WRusman/FluidNC-BOB-v1.1/Schema.png

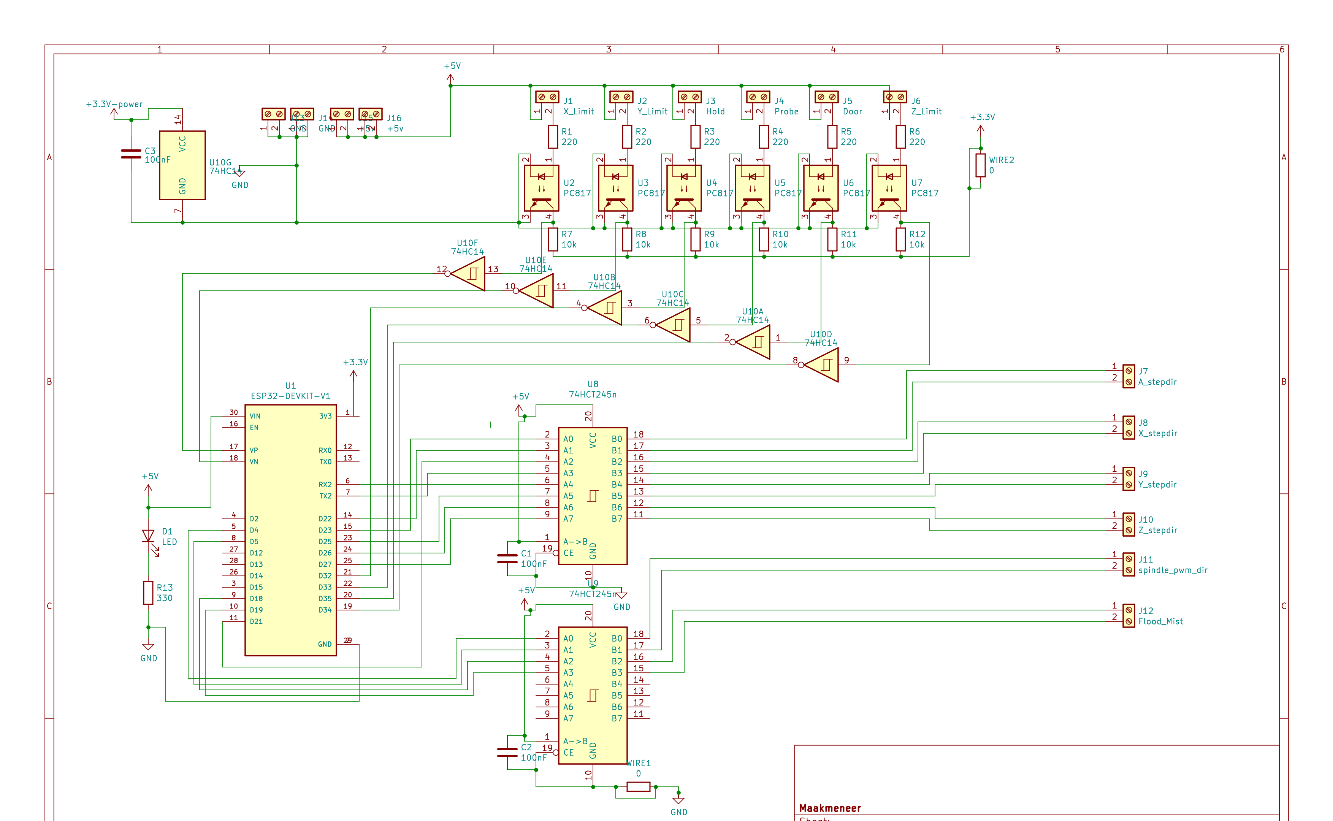
Schema.png
