WRusman/FluidNC-BOB-v1.1/FluidNC-BOB v1.1.kicad_pcb

## KiCad design FluidNC-BOB v1.1.kicad_pcb (2023-03-14)

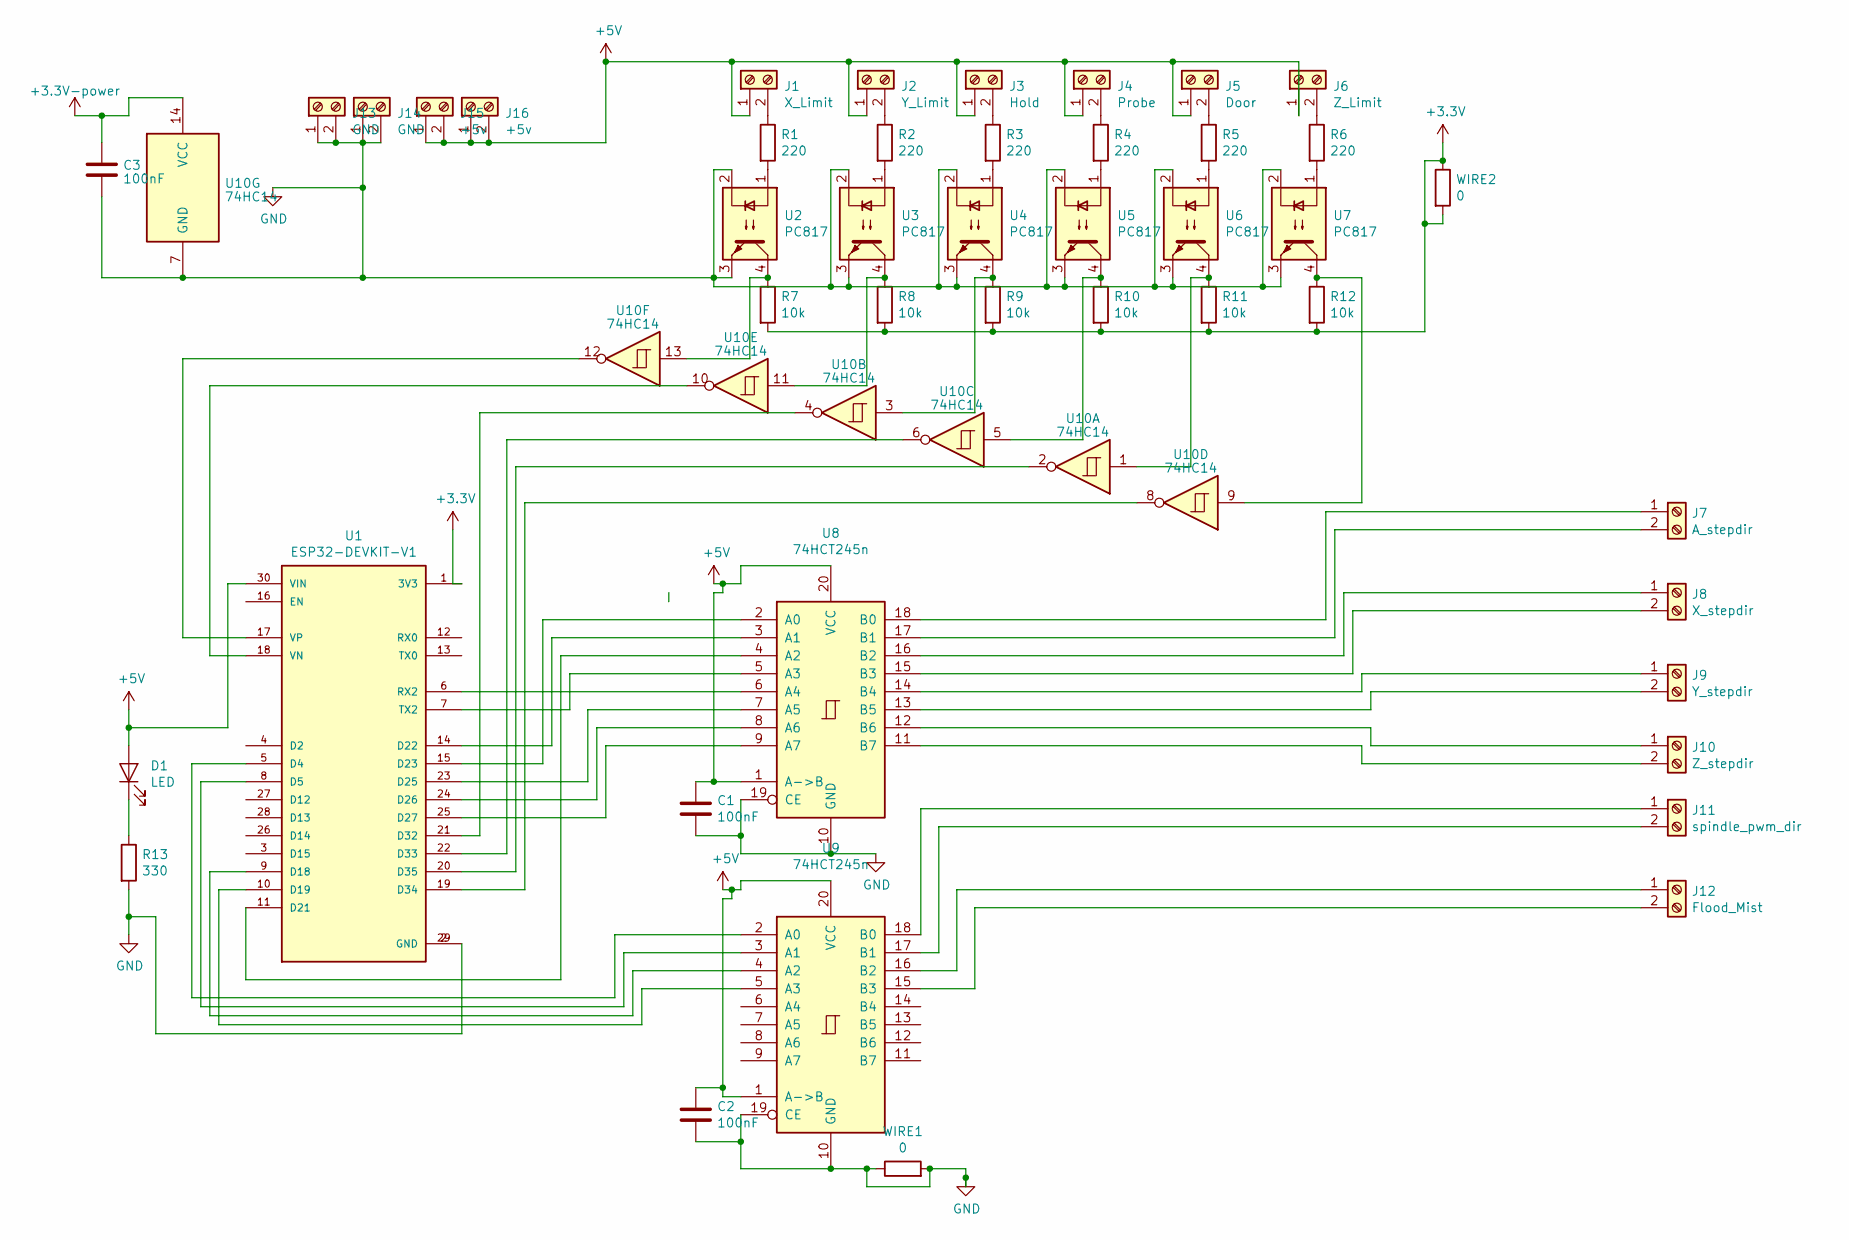
[picture p2: schematic FluidNC-BOB v1.1.kicad_sch, FluidNC Break-Out Board]

Parts:
C1, C2, C3: 100nF; C_Axial_L3.8mm_D2.6mm_P7.50mm_Horizontal
D1: LED; LED_D5.0mm
J1: X_Limit; TerminalBlock_MetzConnect_Type073_RT02602HBLU_1x02_P5.08mm_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
J2: Y_Limit; TerminalBlock_MetzConnect_Type073_RT02602HBLU_1x02_P5.08mm_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
J3: Hold; TerminalBlock_MetzConnect_Type073_RT02602HBLU_1x02_P5.08mm_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
J4: Probe; TerminalBlock_MetzConnect_Type073_RT02602HBLU_1x02_P5.08mm_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
J5: Door; TerminalBlock_MetzConnect_Type073_RT02602HBLU_1x02_P5.08mm_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
J6: Z_Limit; TerminalBlock_MetzConnect_Type073_RT02602HBLU_1x02_P5.08mm_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
J7: A_stepdir; TerminalBlock_MetzConnect_Type073_RT02602HBLU_1x02_P5.08mm_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
J8: X_stepdir; TerminalBlock_MetzConnect_Type073_RT02602HBLU_1x02_P5.08mm_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
J9: Y_stepdir; TerminalBlock_MetzConnect_Type073_RT02602HBLU_1x02_P5.08mm_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
J10: Z_stepdir; TerminalBlock_MetzConnect_Type073_RT02602HBLU_1x02_P5.08mm_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
J11: spindle_pwm_dir; TerminalBlock_MetzConnect_Type073_RT02602HBLU_1x02_P5.08mm_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
J12: Flood_Mist; TerminalBlock_MetzConnect_Type073_RT02602HBLU_1x02_P5.08mm_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
J13, J14: GND; TerminalBlock_MetzConnect_Type073_RT02602HBLU_1x02_P5.08mm_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
J15, J16: +5v; TerminalBlock_MetzConnect_Type073_RT02602HBLU_1x02_P5.08mm_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
R1, R2, R3, R4, R5, R6: 220; R_Axial_DIN0204_L3.6mm_D1.6mm_P7.62mm_Horizontal
R7, R8, R9, R10, R11, R12: 10k; R_Axial_DIN0204_L3.6mm_D1.6mm_P7.62mm_Horizontal
R13: 330; R_Axial_DIN0204_L3.6mm_D1.6mm_P7.62mm_Horizontal
U1: ESP32-DEVKIT-V1; MODULE_ESP32_DEVKIT_V1; PARTREV N/A
U2, U3, U4, U5, U6, U7: PC817; DIP-4_W7.62mm
U8, U9: 74HCT245n; DIP-20_W7.62mm_Socket
U10: 74HC14; DIP-14_W7.62mm_Socket
WIRE1, WIRE2: 0; R_Axial_DIN0207_L6.3mm_D2.5mm_P7.62mm_Horizontal

Connections:
+5V: C1.1, C2.1, D1.2 (A), J1.1, J2.1, J3.1, J4.1, J5.1, J6.1, J15.1, J15.2, J16.1, J16.2, U1.30 (VIN), U8.1 (A->B), U8.20 (VCC), U9.1 (A->B), U9.20 (VCC)
GND: C1.2, C2.2, C3.2, J13.1, J13.2, J14.1, J14.2, R13.2, U1.2 (GND), U1.29 (GND), U2.2, U2.3, U3.2, U3.3, U4.2, U4.3, U5.2, U5.3, U6.2, U6.3, U7.2, U7.3, U8.10 (GND), U8.19 (CE), U9.10 (GND), U9.19 (CE), U10.7 (GND), WIRE1.1, WIRE1.2
unnamed: D1.1 (K), R13.1
unnamed: J1.2, R1.1
unnamed: J2.2, R2.1
unnamed: J3.2, R3.1
unnamed: J4.2, R4.1
unnamed: J5.2, R5.1
unnamed: J6.2, R6.1
unnamed: J7.1, U8.18 (B0)
unnamed: J7.2, U8.17 (B1)
unnamed: J8.1, U8.16 (B2)
unnamed: J8.2, U8.15 (B3)
unnamed: J9.1, U8.14 (B4)
unnamed: J9.2, U8.13 (B5)
unnamed: J10.1, U8.12 (B6)
unnamed: J10.2, U8.11 (B7)
unnamed: J11.1, U9.18 (B0)
unnamed: J11.2, U9.17 (B1)
unnamed: J12.1, U9.16 (B2)
unnamed: J12.2, U9.15 (B3)
unnamed: R1.2, U2.1
unnamed: R2.2, U3.1
unnamed: R3.2, U4.1
unnamed: R4.2, U5.1
unnamed: R5.2, U6.1
unnamed: R6.2, U7.1
unnamed: R7.1, U2.4, U10.13
unnamed: R8.1, U3.4, U10.11
unnamed: R9.1, U4.4, U10.3
unnamed: R10.1, U5.4, U10.5
unnamed: R11.1, U6.4, U10.1
unnamed: R12.1, U7.4, U10.9
unnamed: U1.5 (D4), U9.2 (A0)
unnamed: U1.8 (D5), U9.3 (A1)
unnamed: U1.9 (D18), U9.4 (A2)
unnamed: U1.10 (D19), U9.5 (A3)
unnamed: U1.11 (D21), U8.4 (A2)
unnamed: U1.14 (D22), U8.3 (A1)
unnamed: U1.15 (D23), U8.2 (A0)
unnamed: U1.23 (D25), U8.7 (A5)
unnamed: U1.24 (D26), U8.8 (A6)
unnamed: U1.25 (D27), U8.9 (A7)
unnamed: U1.21 (D32), U10.4
unnamed: U1.22 (D33), U10.6
unnamed: U1.19 (D34), U10.8
unnamed: U1.20 (D35), U10.2
unnamed: U1.6 (RX2), U8.6 (A4)
unnamed: U1.7 (TX2), U8.5 (A3)
unnamed: U1.18 (VN), U10.10
unnamed: U1.17 (VP), U10.12

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
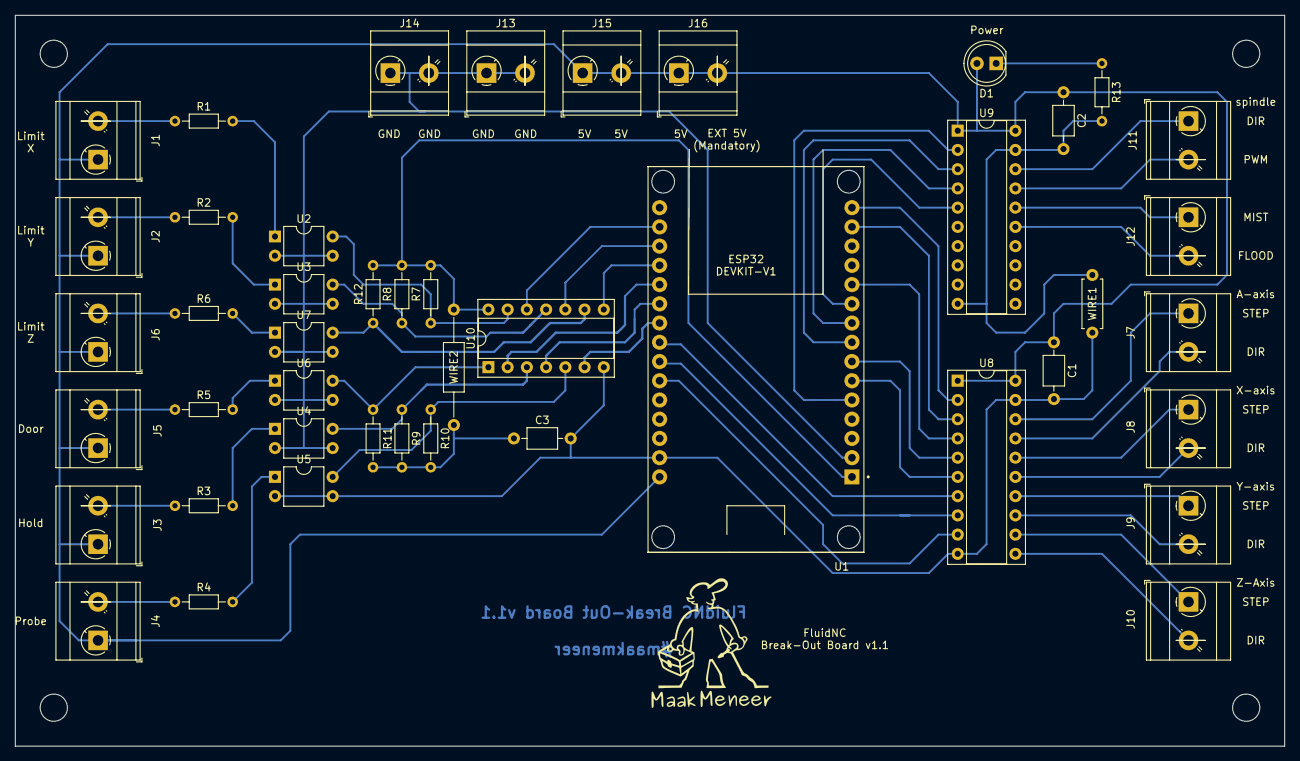
[picture p3: board FluidNC-BOB v1.1.kicad_pcb from above]

Board: 2 copper layers, 167.6 x 96.5 mm, 45 parts (0 on the bottom side), 52 nets.
